DIYsciBorg/AVTokyo2015/BOM.xls

 |  | QTY to Build | 120
 |  |  | AKIZUKI |  |  | COSTS PER |  | PURCHASING
Qty | Reference | Description | Akizuki PN | Qty | Price | piece | board Cost | Pcs Req | Packs | expense
8 | D1, D2, D3, D4, D5, D6, D7, D8 | LED, Green, 5MM | I-03874 | 500 | ¥1900 | ¥3.80 | ¥30.40 | 960 | 1.92 | ¥3648
8 | R1, R2, R3, R4, R5, R6, R7, R8 | Resistor, 470 ohm | R-16471 | 100 | ¥100 | ¥1.00 | ¥8.00 | 960 | 9.6 | ¥960
3 | R9, R10, R11 | Resistor, 10K | R-16103 | 100 | ¥100 | ¥1.00 | ¥3.00 | 360 | 3.6 | ¥360
1 | IC1 | AT-MEGA328P-PU | I-03142 | 1 | ¥250 | ¥250.00 | ¥250.00 | 120 | 120 | ¥30000
1 | BT1 | CR-2032 Battery holder BK883 | P-06925 | 1 | ¥50 | ¥50.00 | ¥50.00 | 120 | 120 | ¥6000
2 | C1, C2 | Capacitor, 0.1uF | P-02181 | 500 | ¥2400 | ¥4.80 | ¥9.60 | 240 | 1 | ¥2400
2 | C3, C4 | Capacitor, 22pF | P-04151 | 500 | ¥1400 | ¥2.80 | ¥5.60 | 240 | 1 | ¥1400
1 | Y1 | Crystal, HC49, 16Mhz | P-08671 | 1 | ¥30 | ¥30.00 | ¥30.00 | 120 | 120 | ¥3600
1 | SW2 | Pushbutton RED | P-03646 | 1 | ¥10 | ¥10.00 | ¥10.00 | 120 | 120 | ¥1200
1 | SW3 | Pushbutton BLUE | P-03649 | 1 | ¥10 | ¥10.00 | ¥10.00 | 120 | 120 | ¥1200
1 | BATTERY | CR2032 | B-05694 | 5 | ¥200 | ¥40.00 | ¥40.00 | 120 | 24 | ¥4800
 |  |  |  |  |  |  | ¥446.60 |  |  | ¥55568
