DIYsciBorg/AVTokyo2015/AVTokyo-2015-Parts-Placement.pdf

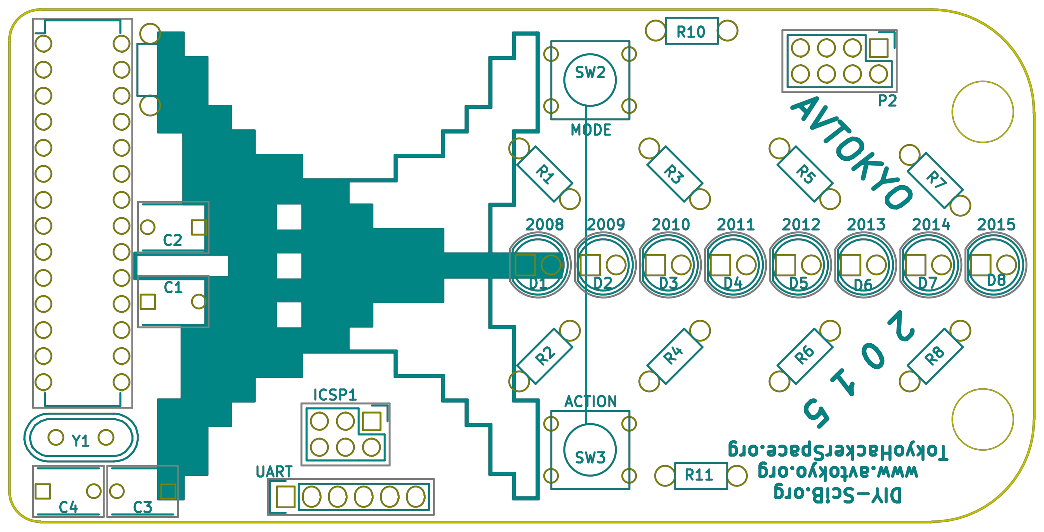
[picture p1: page 1]
