DIYsciBorg/AVTokyo2015/AVTokyo-2015-Schematic.pdf

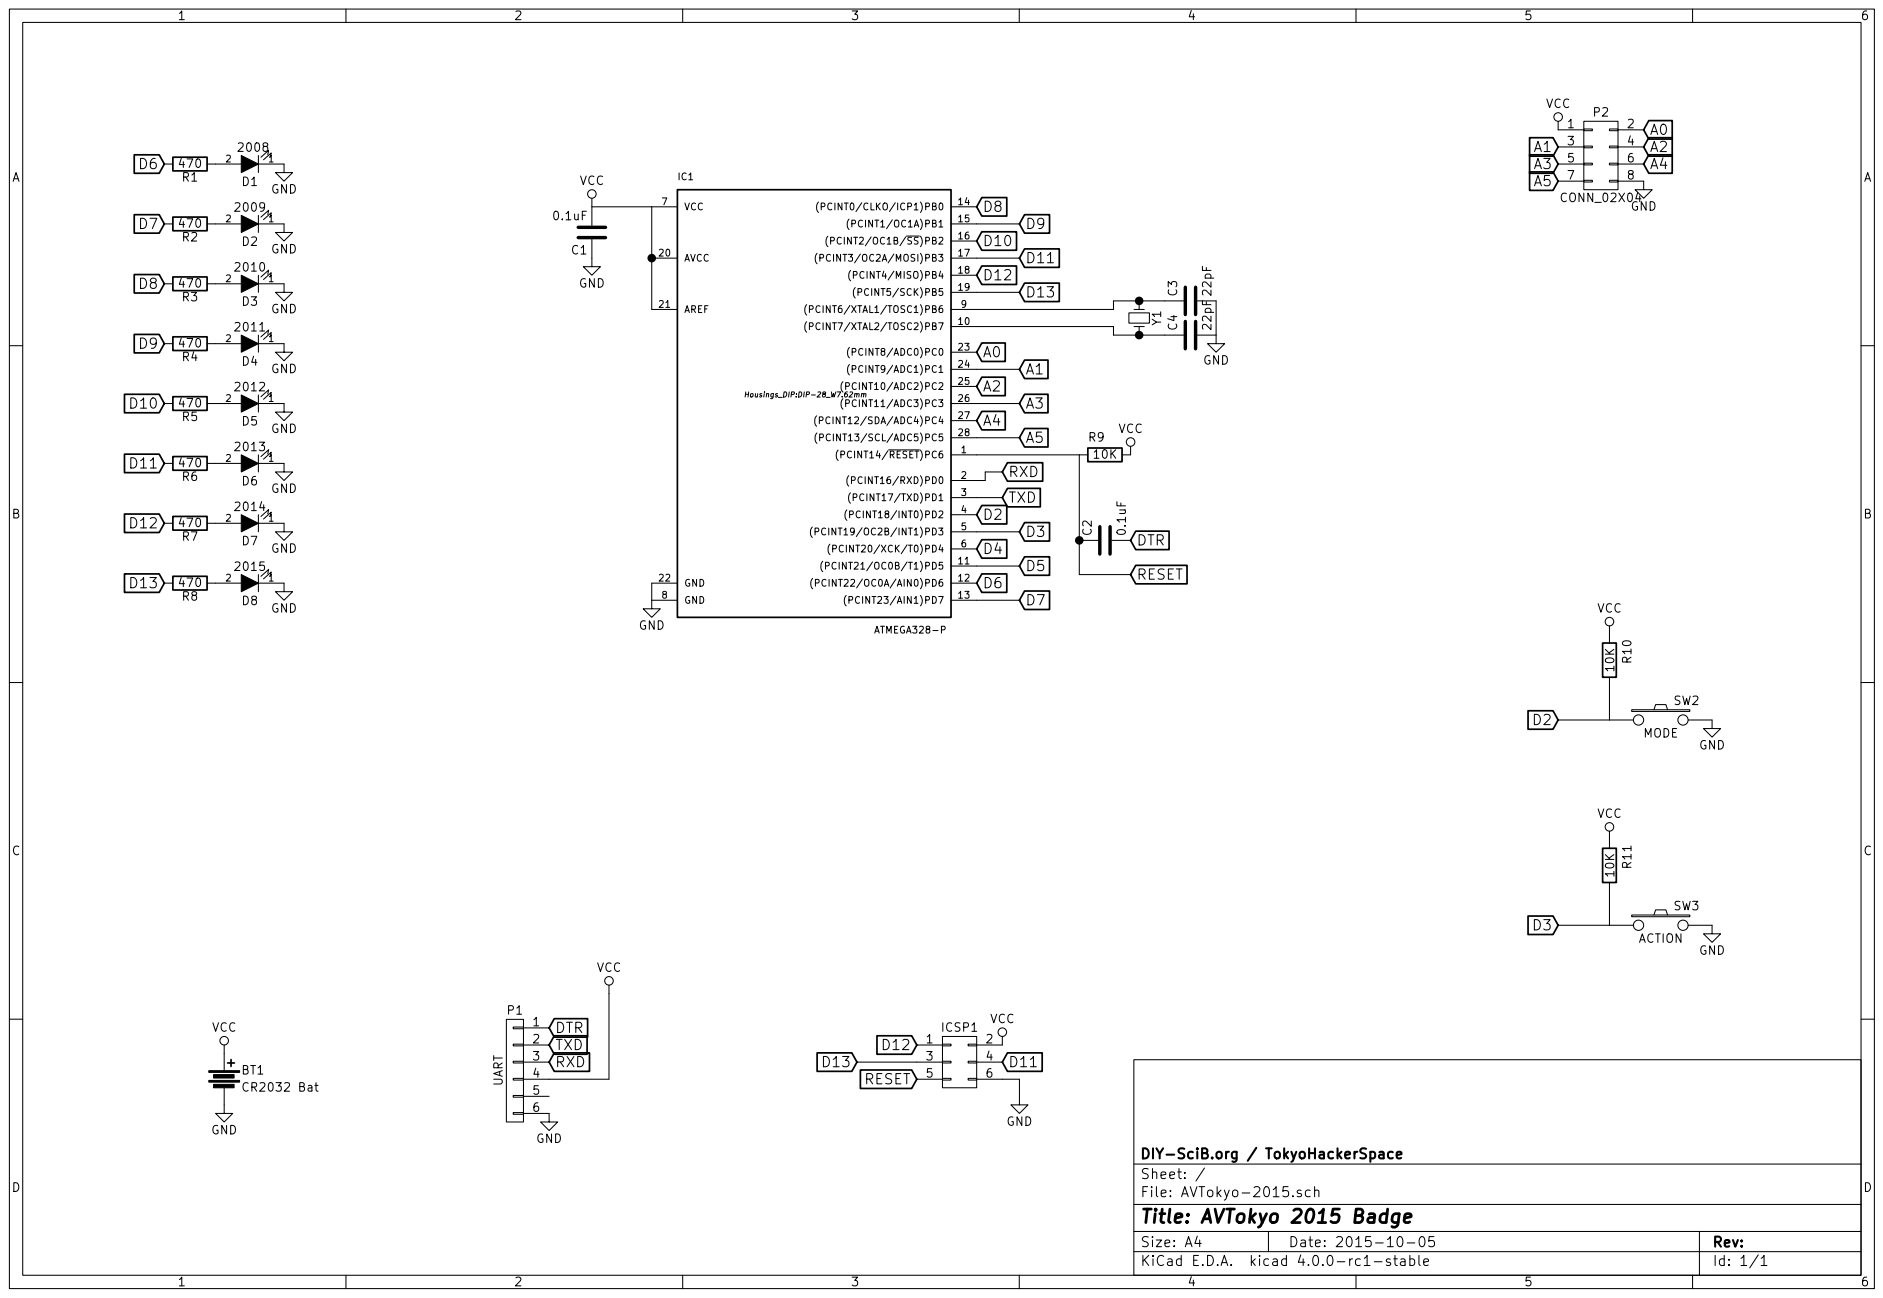
[picture p2: page 1]

Id: 1/1 Title: AVTokyo 2015 Badge
