DIYsciBorg/AVTokyo2015/AVTokyo-2015-Back-Copper.pdf

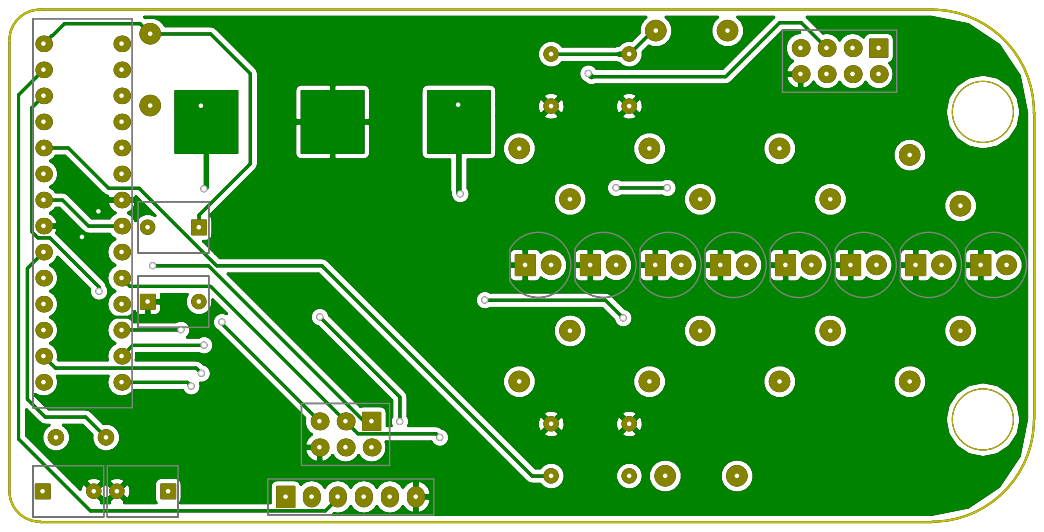
[picture p3: page 1]
