DIYsciBorg/AVTokyo2015/AVTokyo-2015-Front-Copper.pdf

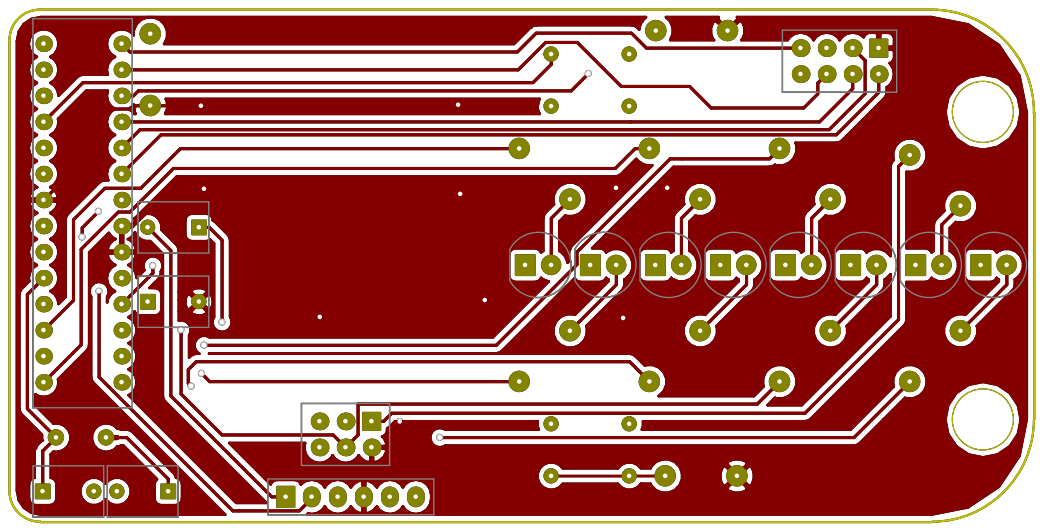
[picture p4: page 1]
