DIYsciBorg/AVTokyo2015/KiCAD/AVtokyo2015-pre.pdf

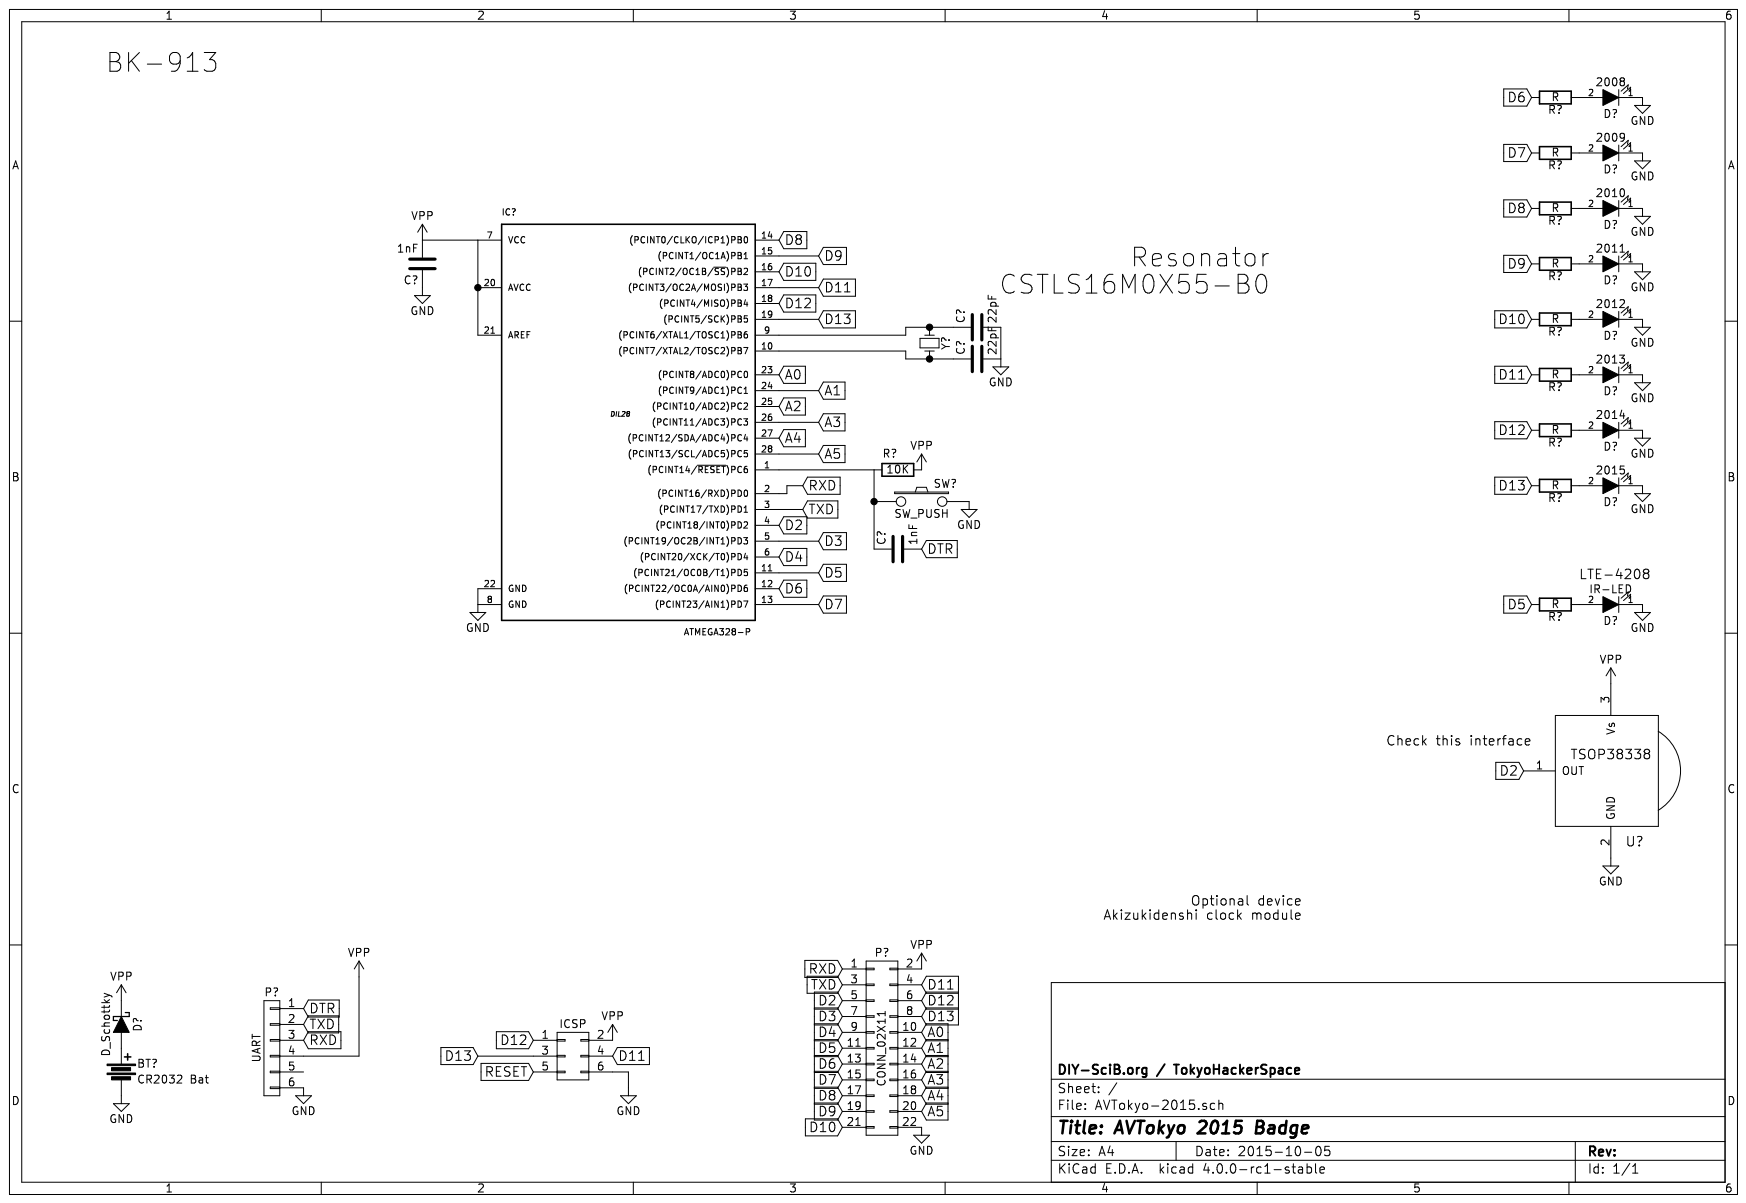
[picture p5: page 1]
