DIYsciBorg/AVTokyo2015/KiCAD/AVTokyo-2015.kicad_pcb

## KiCad design KiCAD/AVTokyo-2015.kicad_pcb (2015-10-27)

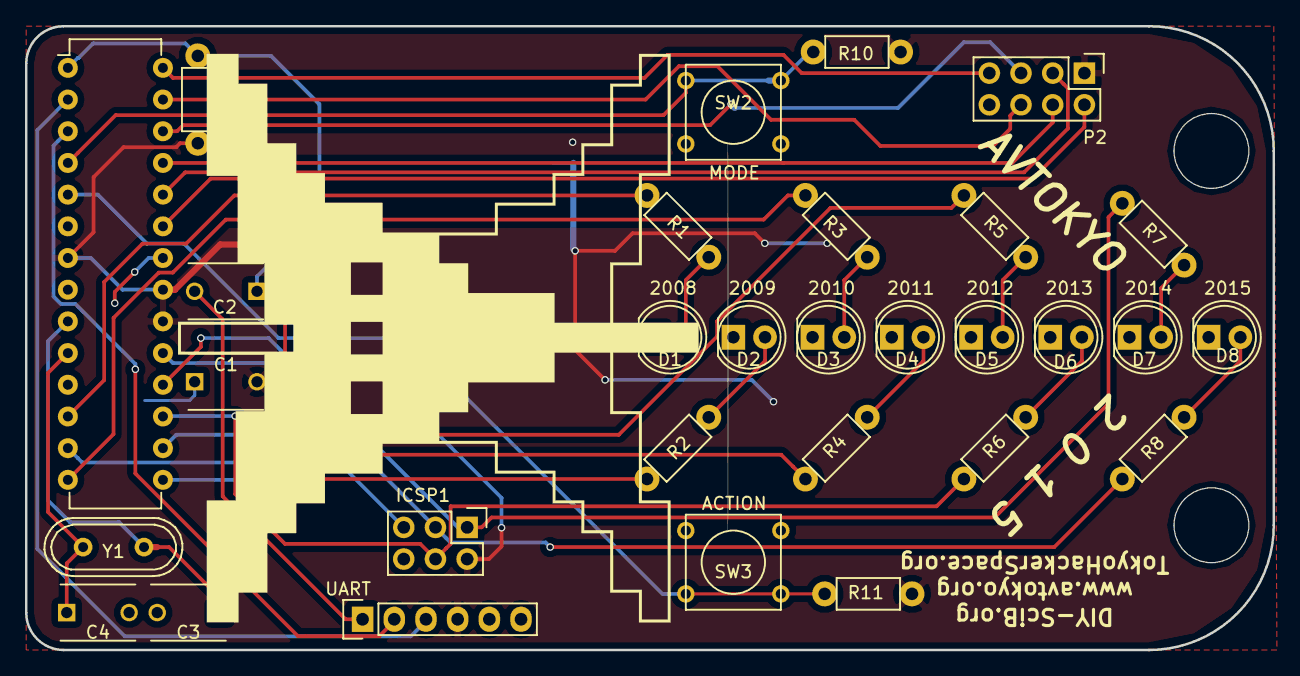
[picture p6: board AVTokyo-2015.kicad_pcb from above]

Board: 2 copper layers, 100.0 x 50.0 mm, 31 parts (1 on the bottom side), 32 nets.

Parts:
BT1: CR2032 Bat; Battery_Holder_20mm_CR2032_BK883
C1, C2: 0.1uF; C_Disc_D6_P5
C3, C4: 22pF; C_Disc_D6_P5
D1: 2008; LED-5MM
D2: 2009; LED-5MM
D3: 2010; LED-5MM
D4: 2011; LED-5MM
D5: 2012; LED-5MM
D6: 2013; LED-5MM
D7: 2014; LED-5MM
D8: 2015; LED-5MM
IC1: ATMEGA328-P; DIP-28_W7.62mm
ICSP1: Pin_Header_Straight_2x03
P1: UART; Pin_Header_Straight_1x06
P2: CONN_02X04; Pin_Header_Straight_2x04
R1, R2, R3, R4, R5, R6, R7, R8: 470; resistor_7mm_8thWatt
R9, R10, R11: 10K; resistor_7mm_8thWatt
SW2: MODE; SW_PUSH_SMALL
SW3: ACTION; SW_PUSH_SMALL
Y1: Crystal_HC49-U_Vertical

Connections:
A0: IC1.23, P2.2
A1: IC1.24, P2.3
A2: IC1.25, P2.4
A3: IC1.26, P2.5
A4: IC1.27, P2.6
A5: IC1.28, P2.7
D2: IC1.4, R10.1, SW2.1
D3: IC1.5, R11.1, SW3.1
D6: IC1.12, R1.2
D7: IC1.13, R2.2
D8: IC1.14, R3.2
D9: IC1.15, R4.2
D10: IC1.16, R5.2
D11: IC1.17, ICSP1.4, R6.2
D12: IC1.18, ICSP1.1, R7.2
D13: IC1.19, ICSP1.3, R8.2
DTR: C2.2, P1.1
GND: BT1.2, C1.1, C3.2, C4.2, D1.1, D2.1, D3.1, D4.1, D5.1, D6.1, D7.1, D8.1, IC1.8, IC1.22, ICSP1.6, P1.6, P2.8, SW2.2, SW3.2
unnamed: C3.1, IC1.9, Y1.1
unnamed: C4.1, IC1.10, Y1.2
unnamed: D1.2, R1.1
unnamed: D2.2, R2.1
unnamed: D3.2, R3.1
unnamed: D4.2, R4.1
unnamed: D5.2, R5.1
unnamed: D6.2, R6.1
unnamed: D7.2, R7.1
unnamed: D8.2, R8.1
RESET: C2.1, IC1.1, ICSP1.5, R9.2
RXD: IC1.2, P1.3
TXD: IC1.3, P1.2
VCC: BT1.1, C1.2, IC1.7, IC1.20, IC1.21, ICSP1.2, P1.4, P2.1, R9.1, R10.2, R11.2
