DIYsciBorg/AVTokyo2015/(commit log)

2015-10-27 initial
    PCB files, BOM and simple demo code
    [AVTokyo-2015-B_Cu.gbr, AVTokyo-2015-B_Mask.gbr, AVTokyo-2015-B_SilkS.gbr, AVTokyo-2015-Edge_Cuts.gbr, AVTokyo-2015-F_Cu.gbr, AVTokyo-2015-F_Mask.gbr, AVTokyo-2015-F_SilkS.gbr, AVTokyo-2015.drl]
2015-10-27 cleanup and docs
    [BOM.xls, BOM.xlsx]
